LouisHLAV/AudioAmpLELT2/0-gain.asc

R5: res; 470
R6: res; 4.7k
R7: res; 4.7k
R15: res; 470
RL: res; 8
V1: voltage; 15
V2: voltage; 15
V3: voltage; SINE(0 0.5 1k 0 0 0); AC 0.5
X1: AudioAmp
Named nets: 0, +Vcc, -Vcc, Vout, Vp, Vn, Vsig
;tran 0 5m 0 0.01u
.FOUR 1khz 51 V(Vout)
.ac dec 51 1 100meg
.meas AC closed_loop_gain FIND V(vout)/V(vsig) AT 1
.meas AC open_loop_gain FIND V(vout)/(V(vp)-V(vn)) AT 1
