LouisHLAV/AudioAmpLELT2/1-bandwidth.asc

R5: res; 470
R6: res; 4.7k
R7: res; 4.7k
R15: res; 470
RL: res; 8
V1: voltage; 15
V2: voltage; 15
V3: voltage; SINE(0 0.5 1k 0 0 0); AC 0.5
X1: AudioAmp
Named nets: 0, +Vcc, -Vcc, Vout, Vp, Vn, Vsig
;tran 0 5m 0 0.01u
.FOUR 1khz 51 V(Vout)
.ac dec 51 1 100meg
.meas AC closed_loop_mag1hz FIND V(vout)/V(vsig) AT 1
.meas AC closed_mag3db PARAM closed_loop_mag1hz/sqrt(2)
.meas AC closed_f3db FIND freq WHEN mag(V(vout)/V(vsig))=closed_mag3db
.meas AC open_loop_mag1hz FIND mag(V(vout)/(V(vp)-V(vn))) AT 1
.meas AC open_mag3db PARAM open_loop_mag1hz/sqrt(2)
.meas AC open_f3db FIND freq WHEN mag(V(vout)/(V(vp)-V(vn)))=open_mag3db
