LouisHLAV/AudioAmpLELT2/5-psrr-positive.asc

R5: res; 470
R6: res; 4.7k
R7: res; 4.7k
R15: res; 470
RL: res; 8
V1: voltage; 15; AC 1
V2: voltage; 15
X1: AudioAmp
Named nets: 0, +Vcc, -Vcc, Vout, Vp, Vn, Vsig
;tran 0 5m 0 0.01u
.FOUR 1khz 51 V(Vout)
.ac dec 51 1 100meg
.MEAS AC psrr_positive FIND V(vout) AT 1
