LouisHLAV/AudioAmpLELT2/7-saturation.asc

R5: res; 470
R6: res; 4.7k
R7: res; 4.7k
R15: res; 470
RL: res; 8
V1: voltage; 15
V2: voltage; 15
V3: voltage; PULSE(-15 15 0 5m 0 0); AC 0.5
X1: AudioAmp
Named nets: 0, +Vcc, -Vcc, Vout, Vp, Vn, Vsig
.tran 0 5m 0 0.1u
;ac dec 51 1 100meg
.MEAS TRAN saturation_negative FIND V(vout) AT 0
.MEAS TRAN saturation_positive FIND V(vout) AT 5m
