LouisHLAV/AudioAmpLELT2/9-slew-rate.asc

R5: res; 470
R6: res; 4.7k
R7: res; 4.7k
R15: res; 470
RL: res; 8
V1: voltage; 15
V2: voltage; 15
V3: voltage; PULSE(0 100m 0.5u 1ns 1ns 1u 2u); AC 0.5
X1: AudioAmp
Named nets: 0, +Vcc, -Vcc, Vout, Vp, Vn, Vsig
.tran 0 2u 0 1n
.FOUR 1khz 51 V(Vout)
;ac dec 51 1 100meg
