LouisHLAV/AudioAmpLELT2/AudioAmp.asc

C1: cap; 10p
D1: diode; 1N4148
D2: diode; 1N4148
D3: diode; 1N4148
D4: diode; 1N4148
D5: diode; 1N4148
Q1: npn; BC547C
Q2: npn
Q3: npn
Q4: pnp; BC557B
Q5: pnp; BC557B
Q6: pnp
Q7: pnp
R1: res; 2.2k
R2: res; 100
R3: res; 3.3k
R4: res; 2.2k
R9: res; 8k
R10: res; 120
R11: res; 8k
R12: res; 120
R13: res; 10
R14: res; 10
Named nets: +Vcc, -Vcc, Vout, Vp, Vn
Modelo de um TIP122
Modelo de um TIP127
