LouisHLAV/AudioAmpLELT2/AmpBasico.asc

C1: cap; 10p
D1: diode; 1N4148
D2: diode; 1N4148
D3: diode; 1N4148
D4: diode; 1N4148
D5: diode; 1N4148
Q1: npn; BC547C
Q2: npn
Q3: npn
Q4: pnp; BC557B
Q5: pnp; BC557B
Q6: pnp
Q7: pnp
R1: res; 2.2k
R2: res; 100
R3: res; 3.3k
R4: res; 2.2k
R5: res; 470
R6: res; 4.7k
R7: res; 4.7k
R8: res; 8
R9: res; 8k
R10: res; 120
R11: res; 8k
R12: res; 120
R13: res; 10
R14: res; 10
R15: res; 470
V1: voltage; 15
V2: voltage; 15
V3: voltage; SINE(0 0.5 1k 0 0 0); AC 0.5
Named nets: 0, +Vcc, -Vcc, Vout
;tran 0 5m 0 0.01u
.FOUR 1khz 51 V(Vout)
Modelo de um TIP122
Modelo de um TIP127
.ac dec 51 1 100meg
