LouisHLAV/AudioAmpLELT2/(commit log)

2021-06-04 Add offset voltage file.
2021-06-04 Add offset voltage file. Rename files.
2021-06-05 Corrected the offset voltage file.
2021-06-21 finish stage 2.
